onenoober/price_overview/_samples/batch2/pdf_text_summary.txt

--- RM-JJ-00083707-01.pdf
技术要求：
1.零件表面不得存在划痕、擦伤等损坏零
件表面的缺陷。 
2.去除毛刺飞边，锐角倒钝。 
3.对于无特殊要求的螺纹孔，需要贯通；
对于未贯通的螺纹孔，有效螺纹深度不小
于螺纹外径的2倍。 
4.加工后存放时必须合理支撑，避免零件
弯曲。 
5.未标注尺寸参见3D。 
6.未标注公差参照右侧标题栏参数。 
105
120
35
2 x 
 5.5 完全贯穿
 4.2 
 12.4
 M5 - 6H 
 10
细牙
2 x 
10.1
5
A
A
10.1
10.1
5 ±0.01
9
119.1
20
A-A
20
此面及棱角处
务必抛光处理
3.2
其余
修订表
标记
修订说明
处数
签名
日期
D
C
A
B
D
C
A
B
6
5
4
3
2
1
6
5
4
3
2
1
>400～1200
±0.2
±0.3
未注公差标记
>30～120 ±0.15
±0.1
±0.05
>120～400
>6～30
>0.5～6
45
投 影
表面
处理
热处理
重量(Kg)
物件料号
0.52
压板
材料
1:1
比 例
征图新视(江苏)科技股份有限公司
Focusight Technology Co.,Ltd
设计
审核
批准
零件类型
镀亮铬
RM-JJ-00083707
方件类
版 本
01
郭江峰
2026-04-24
郭江峰
2026-04-24

--- RM-JJ-00083725-01.pdf
技术要求：
1.零件表面不得存在划痕、擦伤等损坏零
件表面的缺陷。 
2.去除毛刺飞边，锐角倒钝。 
3.对于无特殊要求的螺纹孔，需要贯通；
对于未贯通的螺纹孔，有效螺纹深度不小
于螺纹外径的2倍。 
4.加工后存放时必须合理支撑，避免零件
弯曲。 
5.未标注尺寸参见3D。 
6.未标注公差参照右侧标题栏参数。 
4 x 
 6.8 完全贯穿
M8 - 6H 完全贯穿
8 x 
 3.3 完全贯穿
M4 - 6H 完全贯穿
4 x 
 19.1 完全贯穿
 10.2 完全贯穿
M12 - 6H 完全贯穿
4 x 
 4.2 完全贯穿
M5 - 6H 完全贯穿
0
15
45
37.5
62.5
70
100
130
137.5
162.5
155
185
200
0
5.5
15
20
34.5
42.5
87.5
57.5
72.5
65
95.5
110
124.5
115
130
12 ±0.02
3.2
其余
修订表
标记
修订说明
处数
签名
日期
D
C
A
B
D
C
A
B
6
5
4
3
2
1
6
5
4
3
2
1
>400～1200
±0.2
±0.3
未注公差标记
>30～120 ±0.15
±0.1
±0.05
>120～400
>6～30
>0.5～6
6061
投 影
表面
处理
热处理
重量(Kg)
物件料号
0.72
传动护罩
材料
1:1
比 例
征图新视(江苏)科技股份有限公司
Focusight Technology Co.,Ltd
设计
审核
批准
零件类型
本色氧化，喷砂
RM-JJ-00083725
方件类
版 本
01
郭江峰
2026-04-24
郭江峰
2026-04-24

--- RM-JJ-00083828-01.pdf
技术要求：
1.零件表面不得存在划痕、擦伤等损坏零
件表面的缺陷。 
2.去除毛刺飞边，锐角倒钝。 
3.对于无特殊要求的螺纹孔，需要贯通；
对于未贯通的螺纹孔，有效螺纹深度不小
于螺纹外径的2倍。 
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
㣊㘜
㦶㠻
D
C
A
B
D
C
A
B
6
5
4
3
2
1
6
5
4
3
2
1
>400～1200
±0.2
±0.3
未注公差标记
>30～120 ±0.15
±0.1
±0.05
>120～400
>6～30
>0.5～6
Q235A
投 影
表面
处理
热处理
重量(Kg)
物件料号
5.18
输送支撑架
材料
1:6
比 例
征图新视(江苏)科技股份有限公司
Focusight Technology Co.,Ltd
设计
审核
批准
零件类型
喷塑小桔纹白色
RM-JJ-00084398
方件类
版 本
01
赵洲
2026-04-24
赵洲
2026-04-24
