onenoober/price_overview/_samples/five/pdf_text_summary.txt

--- RM-JJ-00083854-01.pdf
技术要求：
1.零件表面不得存在划痕、擦伤等损坏零
件表面的缺陷。 
2.去除毛刺飞边，锐角倒钝。 
3.对于无特殊要求的螺纹孔，需要贯通；
对于未贯通的螺纹孔，有效螺纹深度不小
于螺纹外径的2倍。 
4.加工后存放时必须合理支撑，避免零件
弯曲。 
5.未标注尺寸参见3D。 
6.未标注公差参照右侧标题栏参数。 
62 ±0.05
80.5
12
12
22.5
30
70
2 x 
 5 完全贯穿
M6 - 6H 完全贯穿
10.2
10
50
2 x 
 3.3 
 10.1
M4 - 6H 
 8
3 x 
 5 
 15
M6 - 6H 
 12
4 H7 X 5 
 15
 4 H7 
 15
20
0
10
22.5 ±0.02
35
60
47.5
3.2
其余
修订表
标记
修订说明
处数
签名
日期
D
C
A
B
D
C
A
B
6
5
4
3
2
1
6
5
4
3
2
1
>400～1200
±0.2
±0.3
未注公差标记
>30～120 ±0.15
±0.1
±0.05
>120～400
>6～30
>0.5～6
45
投 影
表面
处理
热处理
重量(Kg)
物件料号
0.796
后侧板
材料
1:1
比 例
征图新视(江苏)科技股份有限公司
Focusight Technology Co.,Ltd
设计
审核
批准
零件类型
镀硬铬
RM-JJ-00083854
方件类
版 本
01
郭江峰
2026-04-24
郭江峰
2026-04-24

--- RM-JJ-00083859-01.pdf
技术要求：
1.零件表面不得存在划痕、擦伤等损坏零
件表面的缺陷。 
2.去除毛刺飞边，锐角倒钝。 
3.对于无特殊要求的螺纹孔，需要贯通；
对于未贯通的螺纹孔，有效螺纹深度不小
于螺纹外径的2倍。 
4.加工后存放时必须合理支撑，避免零件
弯曲。 
5.未标注尺寸参见3D。 
6.未标注公差参照右侧标题栏参数。 
25
80
115
110
150
EQS 4 x 
 5 完全贯穿
 M6 - 6H 完全贯穿
P.C.D 
56
2 x 
 12.2 完全贯穿
2 x 
 12.2 完全贯穿
6 x 
 9 完全贯穿
0
20
60
70
120
173 ±0.02
200
40
56
A
A
70
 4.2 贯穿
M5 - 6H 贯穿
12 ±0.02
 4.2 贯穿
M5 - 6H 贯穿
70
45 H7
12
A-A
3.2
其余
修订表
标记
修订说明
处数
签名
日期
D
C
A
B
D
C
A
B
6
5
4
3
2
1
6
5
4
3
2
1
>400～1200
±0.2
±0.3
未注公差标记
>30～120 ±0.15
±0.1
±0.05
>120～400
>6～30
>0.5～6
45
投 影
表面
处理
热处理
重量(Kg)
物件料号
1.984
张紧墙板
材料
1:1
比 例
征图新视(江苏)科技股份有限公司
Focusight Technology Co.,Ltd
设计
审核
批准
零件类型
镀硬铬
RM-JJ-00083859
方件类
版 本
01
郭江峰
2026-04-24
郭江峰
2026-04-24

--- RM-JJ-00083878-01.pdf
技术要求：
1.零件表面不得存在划痕、擦伤等损坏零
件表面的缺陷。 
2.去除毛刺飞边，锐角倒钝。 
3.对于无特殊要求的螺纹孔，需要贯通；
对于未贯通的螺纹孔，有效螺纹深度不小
于螺纹外径的2倍。 
4.加工后存放时必须合理支撑，避免零件
弯曲。 
5.未标注尺寸参见3D。 
6.未标注公差参照右侧标题栏参数。 
40
50
8
70
25
9 X 21 完全贯穿
80
20
30
2 x 
 7 完全贯穿
12
12
零件可拼焊接
3.2
其余
修订表
标记
修订说明
处数
签名
日期
D
C
A
B
D
C
A
B
6
5
4
3
2
1
6
5
4
3
2
1
>400～1200
±0.2
±0.3
未注公差标记
>30～120 ±0.15
±0.1
±0.05
>120～400
>6～30
>0.5～6
45
投 影
表面
处理
热处理
重量(Kg)
物件料号
0.610
L脚
材料
1:1
比 例
征图新视(江苏)科技股份有限公司
Focusight Technology Co.,Ltd
设计
审核
批准
零件类型
镀硬铬
RM-JJ-00083878
方件类
版 本
01
郭江峰
2026-04-24
郭江峰
2026-04-24

--- RM-JJ-00083991-01.pdf
技术要求：
1.零件表面不得存在划痕、擦伤等损坏
零件表面的缺陷。 
2.去除毛刺飞边，锐角倒钝。 
3.未标注尺寸参见3D。 
4.未标注公差参照右侧标题栏参数。 
10
27.5
45
80
11
6.6
C1
A
A
8 
+
 
0.02
0
5.5
10
5.7
2
6.8
15
A-A
镀化学镍
3.2
其余
修订表
标记
处数
修订说明
签名
日期
>400～1200
±0.2
±0.3
未注公差标记
>30～120 ±0.15
±0.1
±0.05
>120～400
>6～30
>0.5～6
45
投 影
表面
处理
热处理
重量(Kg)
D
C
A
B
3
5
2
6
4
1
物件料号RM-JJ-00083991
轴承安装板
镀化学镍
材料
1:1
比 例
征图新视(江苏)科技股份有限公司
Focusight Technology Co.,Ltd
D
设计
审核
5
6
4
3
C
批准
A
B
2
1
零件类型
0.08
方件类
版本
01
赵洲
2026-04-24
赵洲
2026-04-24

--- RM-JJ-00084339-01.pdf
技术要求：
1.零件表面不得存在划痕、擦伤等损坏零
件表面的缺陷。 
2.去除毛刺飞边，锐角倒钝。 
3.对于无特殊要求的螺纹孔，需要贯通；
对于未贯通的螺纹孔，有效螺纹深度不小
于螺纹外径的2倍。 
4.加工后存放时必须合理支撑，避免零件
弯曲。 
5.未标注尺寸参见3D。 
6.未标注公差参照右侧标题栏参数。 
11
95.8
15
2 x 
 5.5 完全贯穿
 10 
 5.7
7.5
20 
+
+
0.50
0.20
5
37.9
 M6 - 6H 
 12
 5 
 17两端
15
20
10
3.2
其余
修订表
标记
修订说明
处数
签名
日期
D
C
A
B
D
C
A
B
6
5
4
3
2
1
6
5
4
3
2
1
>400～1200
±0.2
±0.3
未注公差标记
>30～120 ±0.15
±0.1
±0.05
>120～400
>6～30
>0.5～6
6061
投 影
表面
处理
热处理
重量(Kg)
物件料号
0.068
对接流利条支撑板
材料
1:1
比 例
征图新视(江苏)科技股份有限公司
Focusight Technology Co.,Ltd
设计
审核
批准
零件类型
本色阳极氧化
RM-JJ-00084339
方件类
版 本
01
赵洲
2026-04-24
赵洲
2026-04-24
