onenoober/price_overview/_samples/batch2/rendered/RM-JJ-00083841-01.png

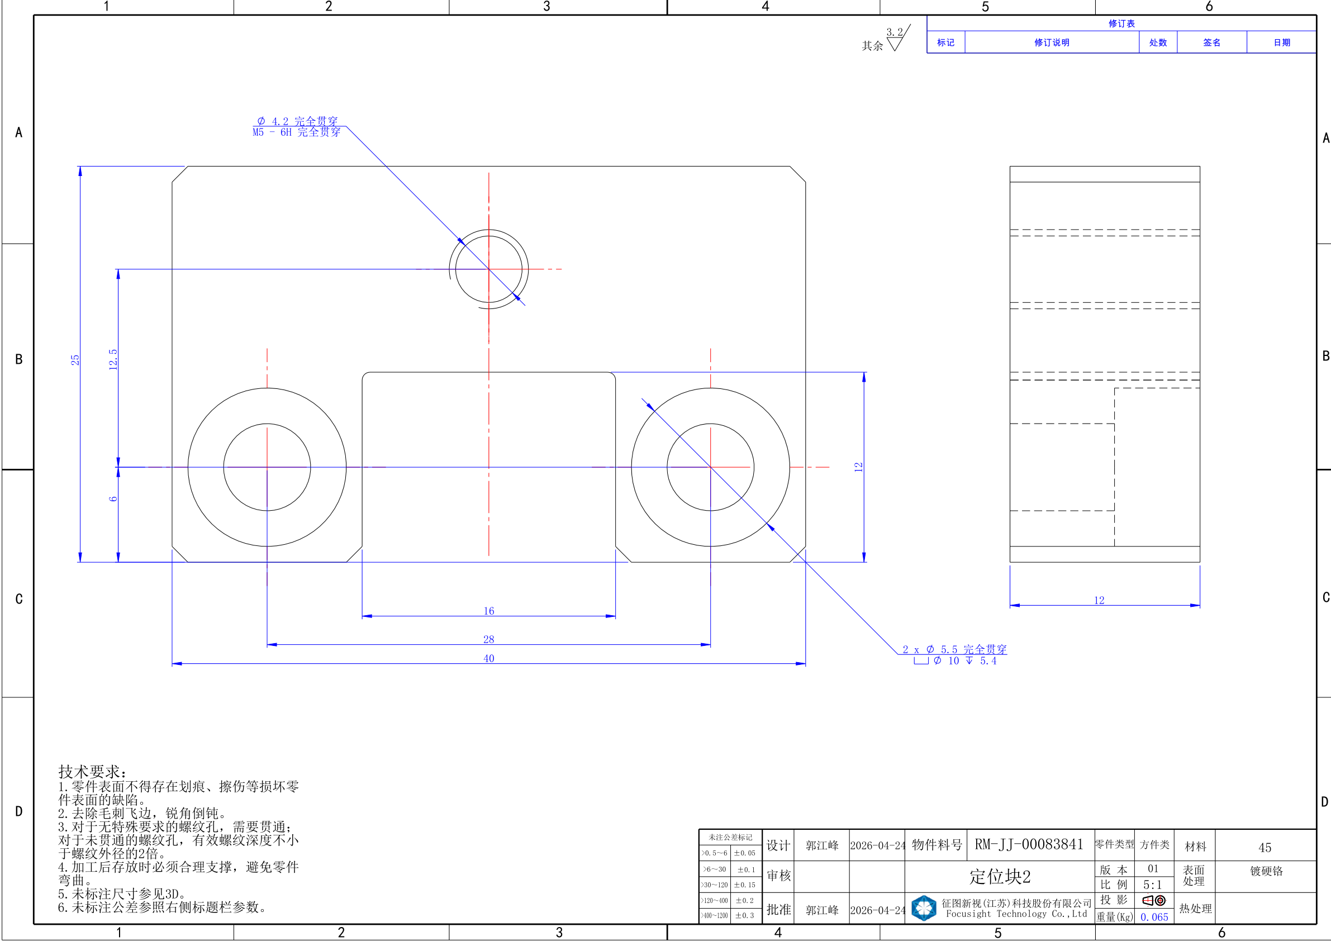
_samples/batch2/rendered/RM-JJ-00083841-01.png
