onenoober/price_overview/_samples/batch2/rendered/RM-JJ-00084186-01.png

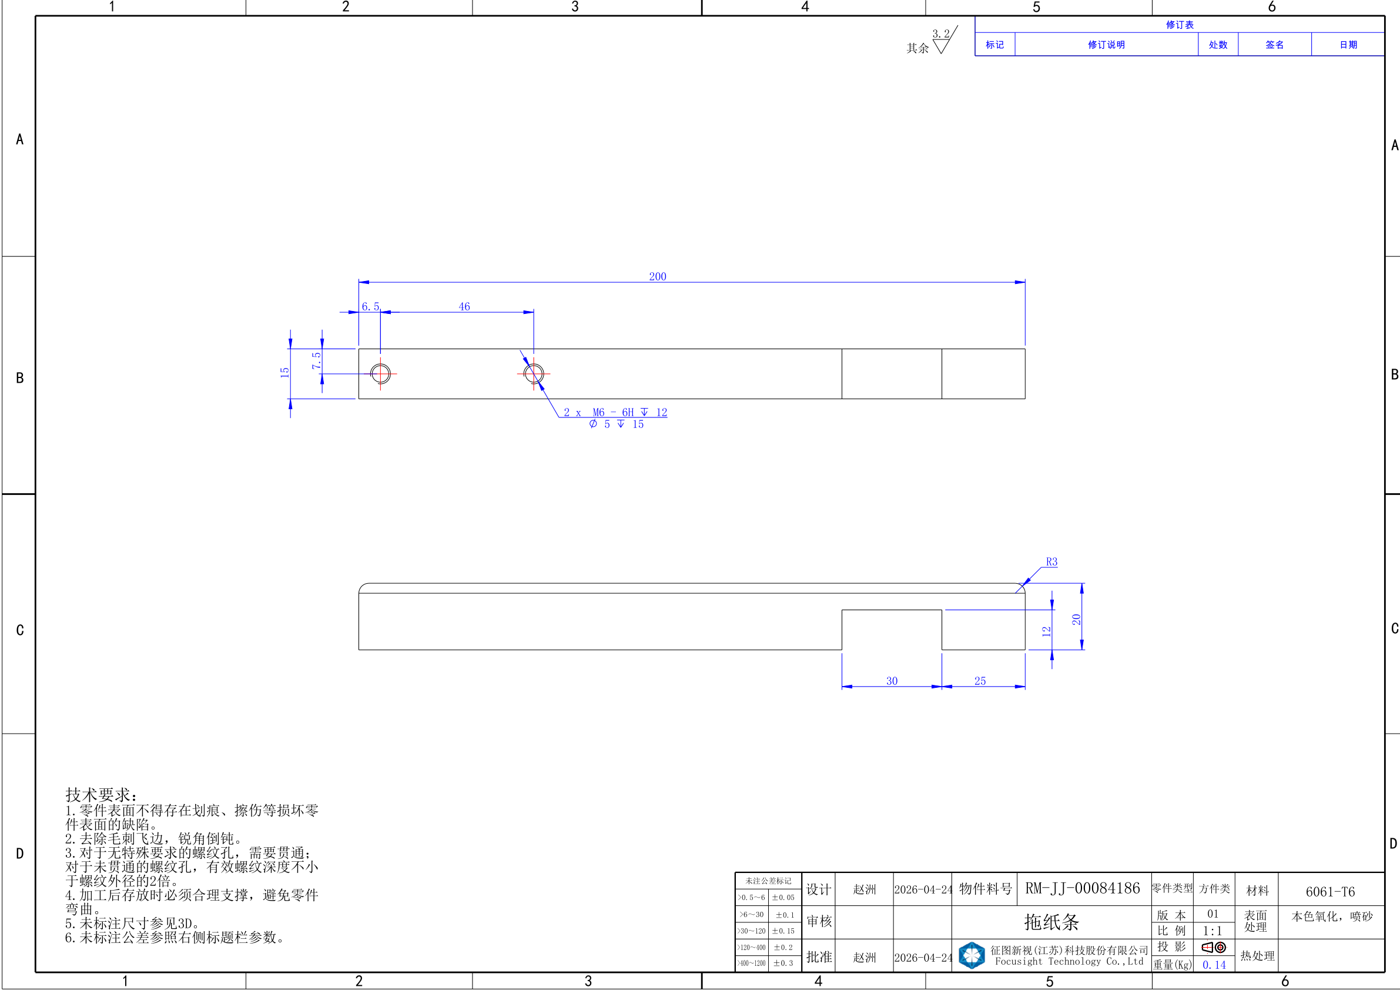
_samples/batch2/rendered/RM-JJ-00084186-01.png
