onenoober/price_overview/_samples/five/rendered/RM-JJ-00083878-01.png

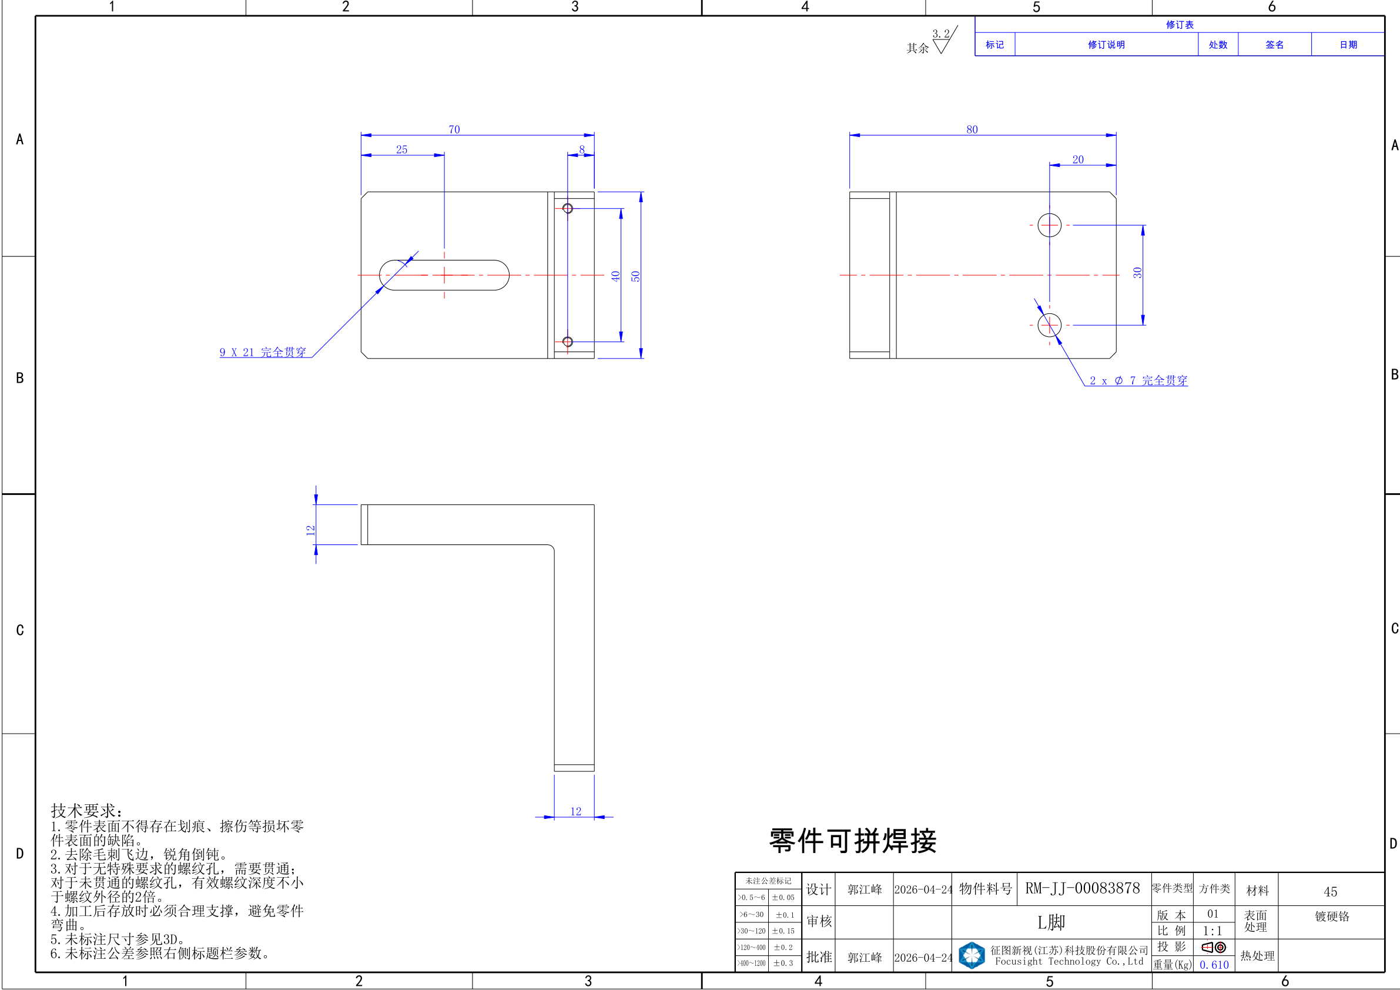
_samples/five/rendered/RM-JJ-00083878-01.png
