onenoober/price_overview/_samples/five/rendered/RM-JJ-00083991-01.png

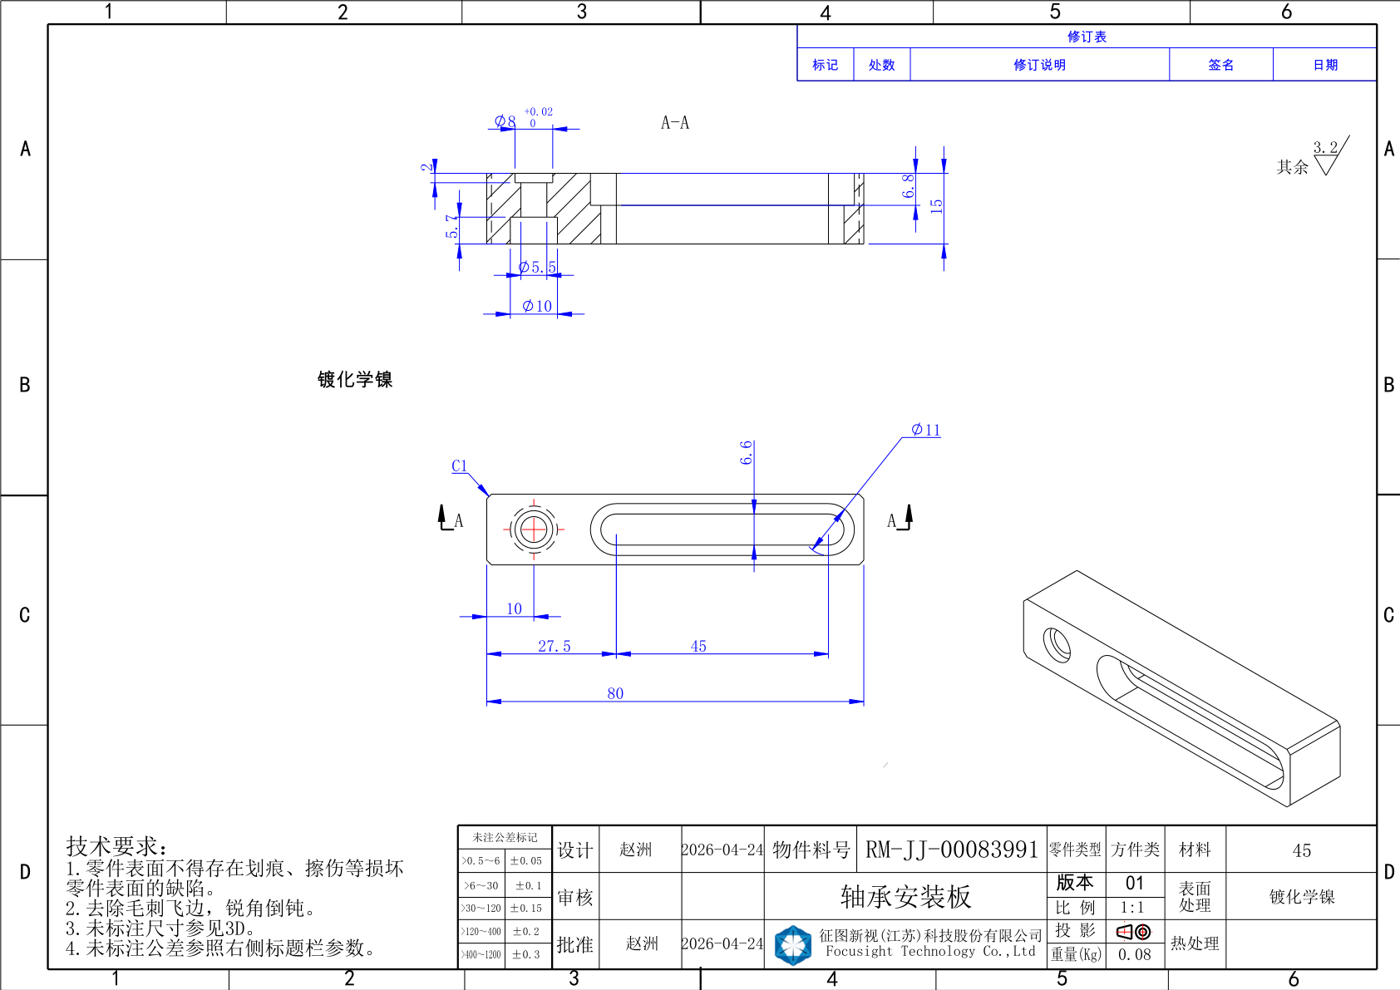
_samples/five/rendered/RM-JJ-00083991-01.png
