onenoober/price_overview/_samples/batch2/RM-JJ-00084186-01.step

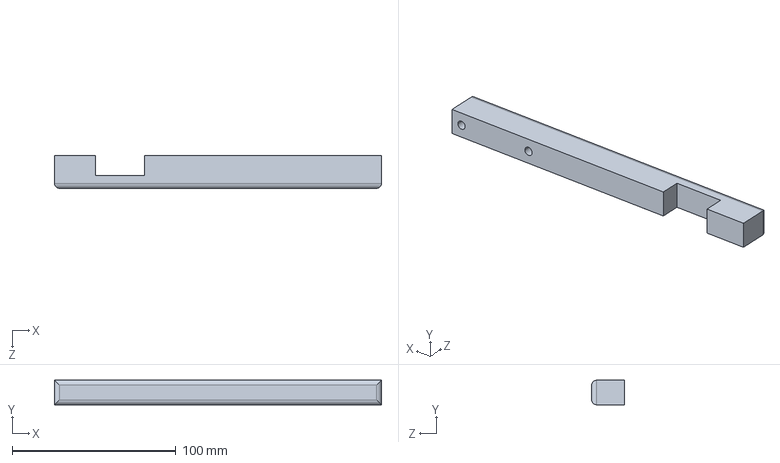
[picture p15: CAD file, 2026-07-01]
_samples/batch2/RM-JJ-00084186-01.step
200.0 x 15.0 x 20.0 mm
