onenoober/price_overview/_samples/five/RM-JJ-00083878-01.step

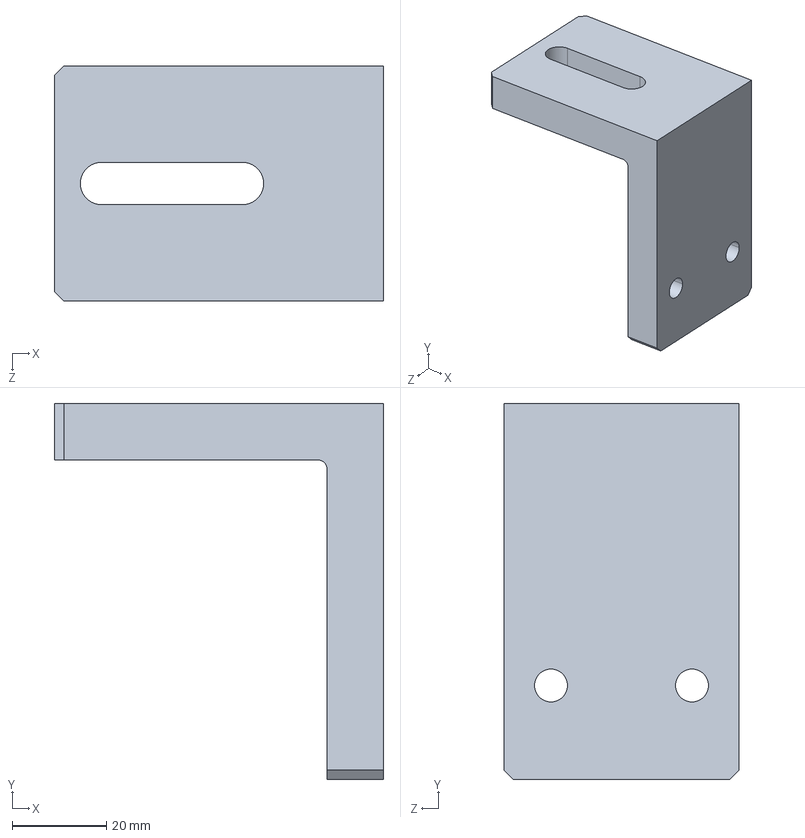
[picture p16: CAD file, 2026-07-01]
_samples/five/RM-JJ-00083878-01.step
70.0 x 80.0 x 50.0 mm
