onenoober/price_overview/_samples/batch2/RM-JJ-00084398-01.step

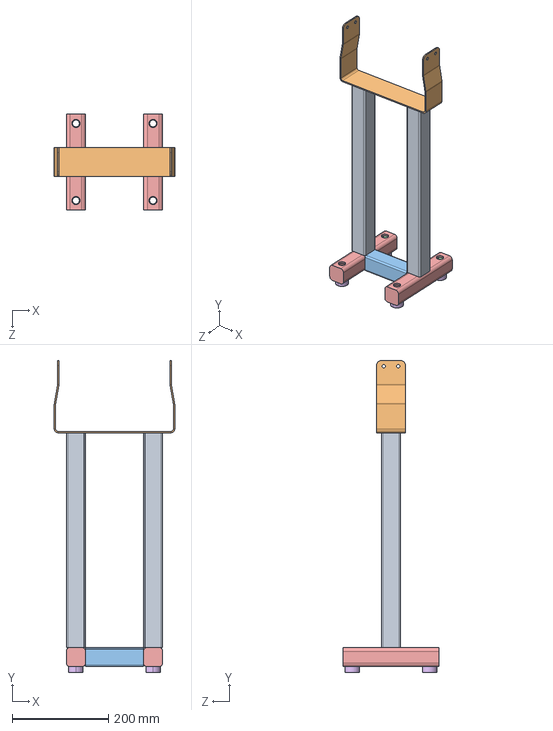
[picture p17: CAD file, 2026-07-01]
_samples/batch2/RM-JJ-00084398-01.step
250.0 x 647.0 x 200.0 mm
