onenoober/price_overview/_samples/five/RM-JJ-00083991-01.step

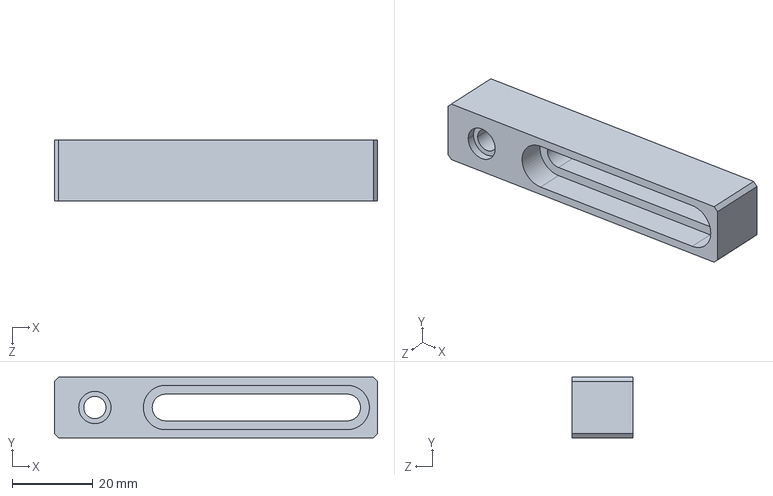
[picture p20: CAD file, 2026-07-01]
_samples/five/RM-JJ-00083991-01.step
80.0 x 15.0 x 15.0 mm
