onenoober/price_overview/_samples/batch2/RM-JJ-00083707-01.step

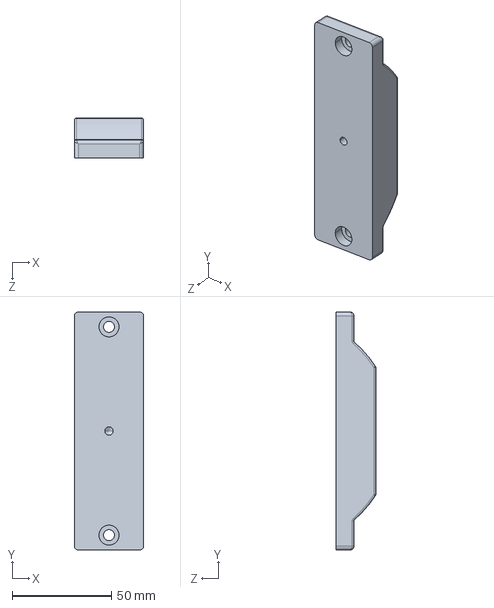
[picture p21: CAD file, 2026-07-01]
_samples/batch2/RM-JJ-00083707-01.step
35.0 x 120.0 x 20.0 mm
