onenoober/price_overview/_samples/batch2/RM-JJ-00083841-01.step

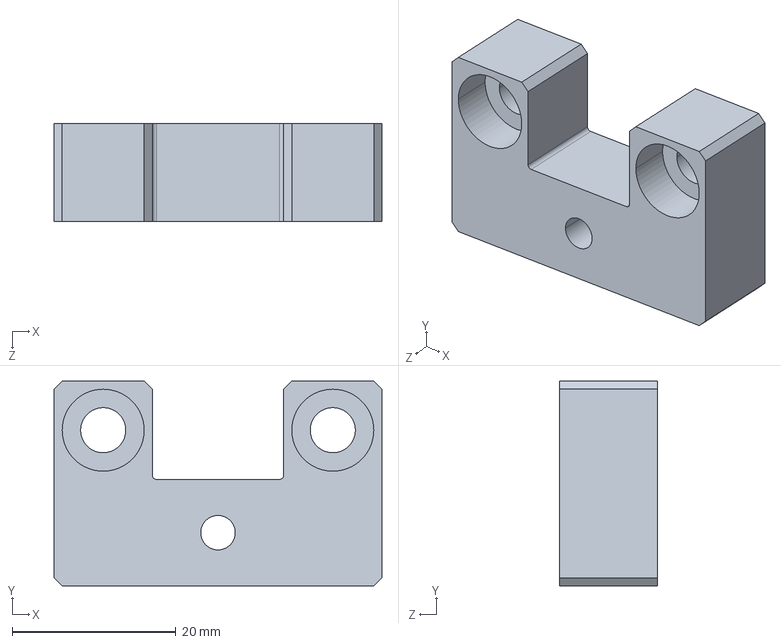
[picture p24: CAD file, 2026-07-01]
_samples/batch2/RM-JJ-00083841-01.step
40.0 x 25.0 x 12.0 mm
