onenoober/price_overview/_samples/batch2/RM-JJ-00083707-01.pdf

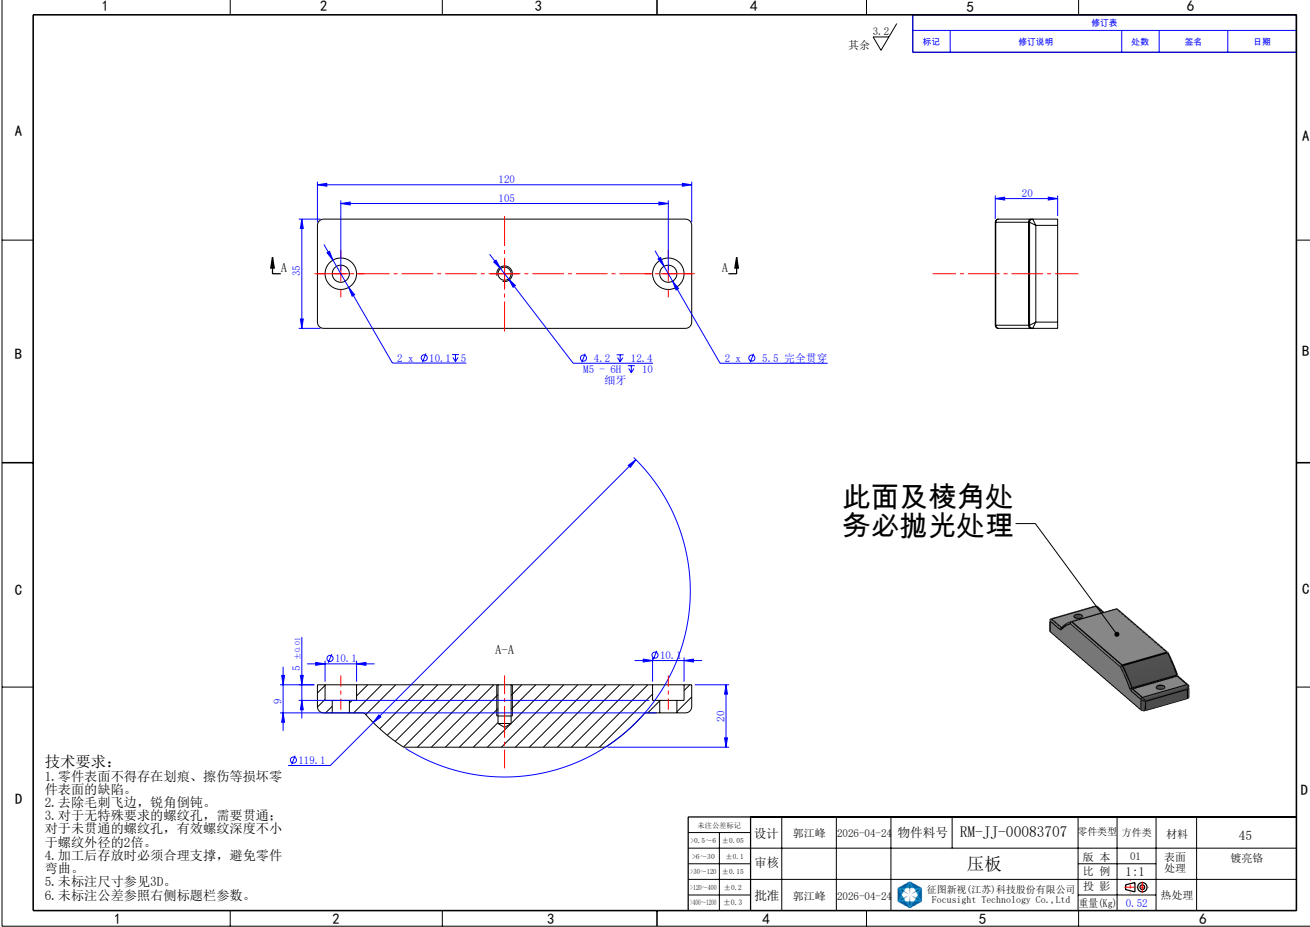
[picture p25: page 1]
5.5 完全贯穿

修订表

标记 | 修订说明 | 处数 | 签名 | 日期

征图新视(江苏)科技股份有限公司
Focusight Technology Co.,Ltd

0.52 | 热处理 重量(Kg)
