onenoober/price_overview/_samples/batch2/RM-JJ-00083841-01.pdf

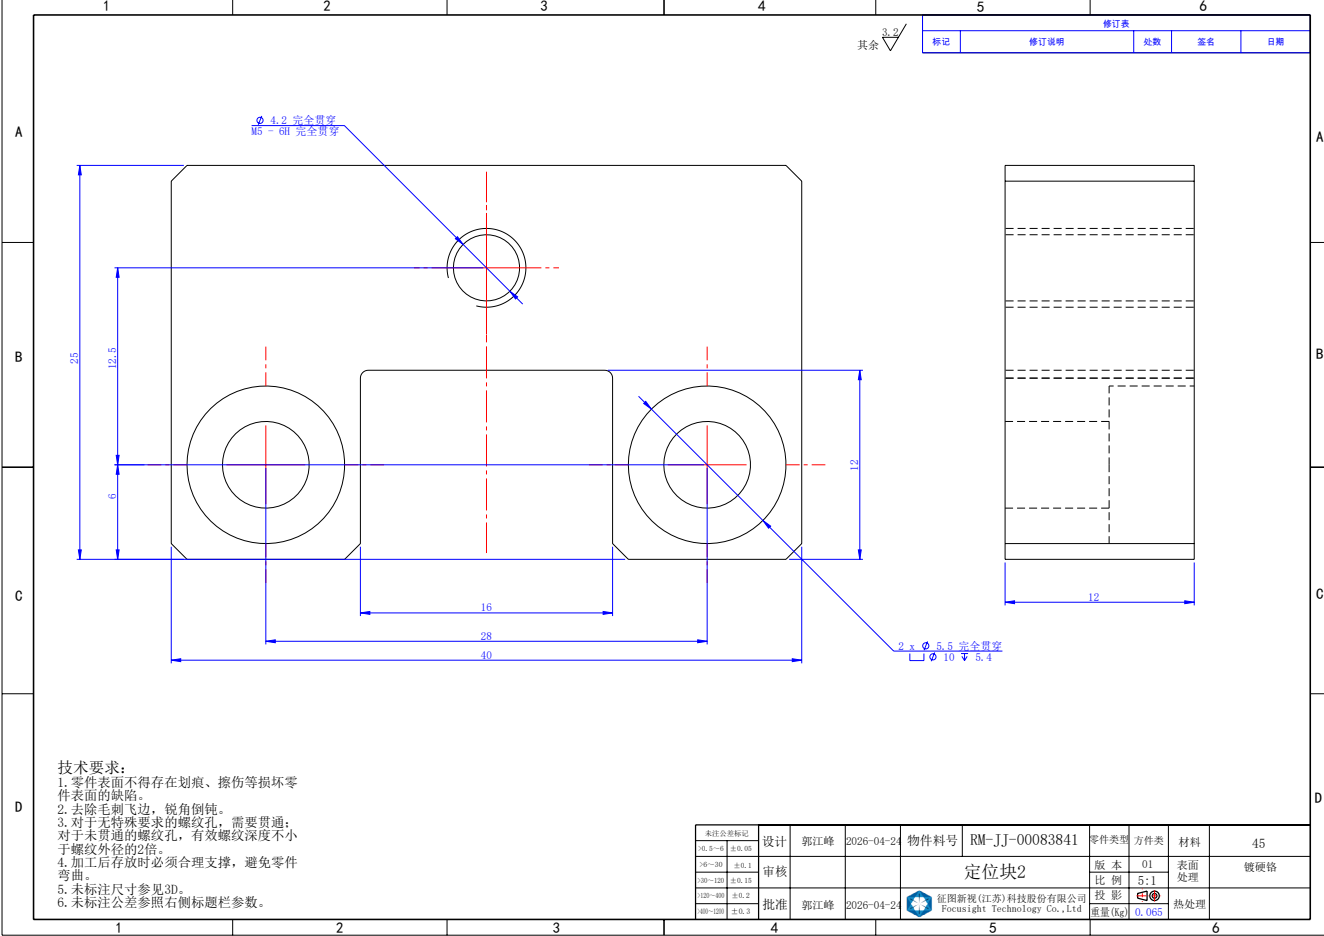
[picture p28: page 1]
4.2 完全贯穿 M5 - 6H 完全贯穿; 5.5 完全贯穿

修订表

标记 | 修订说明 | 处数 | 签名 | 日期

征图新视(江苏)科技股份有限公司
Focusight Technology Co.,Ltd

0.065 | 热处理 重量(Kg)
