onenoober/price_overview/_samples/batch2/RM-JJ-00084186-01.pdf

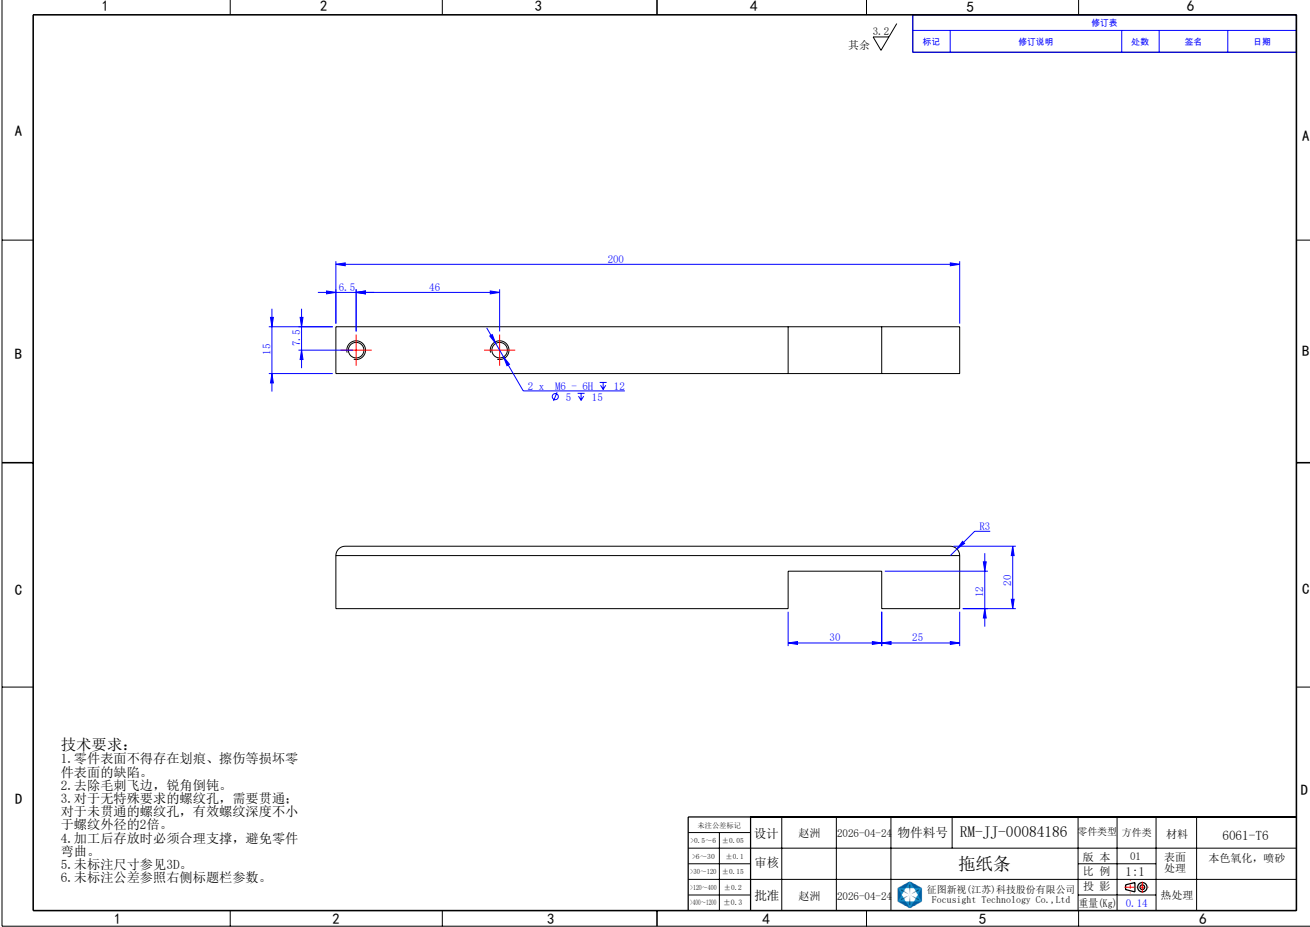
[picture p30: page 1]

修订表

标记 | 修订说明 | 处数 | 签名 | 日期

征图新视(江苏)科技股份有限公司
Focusight Technology Co.,Ltd

0.14 | 热处理 重量(Kg)
