onenoober/price_overview/_samples/batch2/RM-JJ-00084398-01.pdf

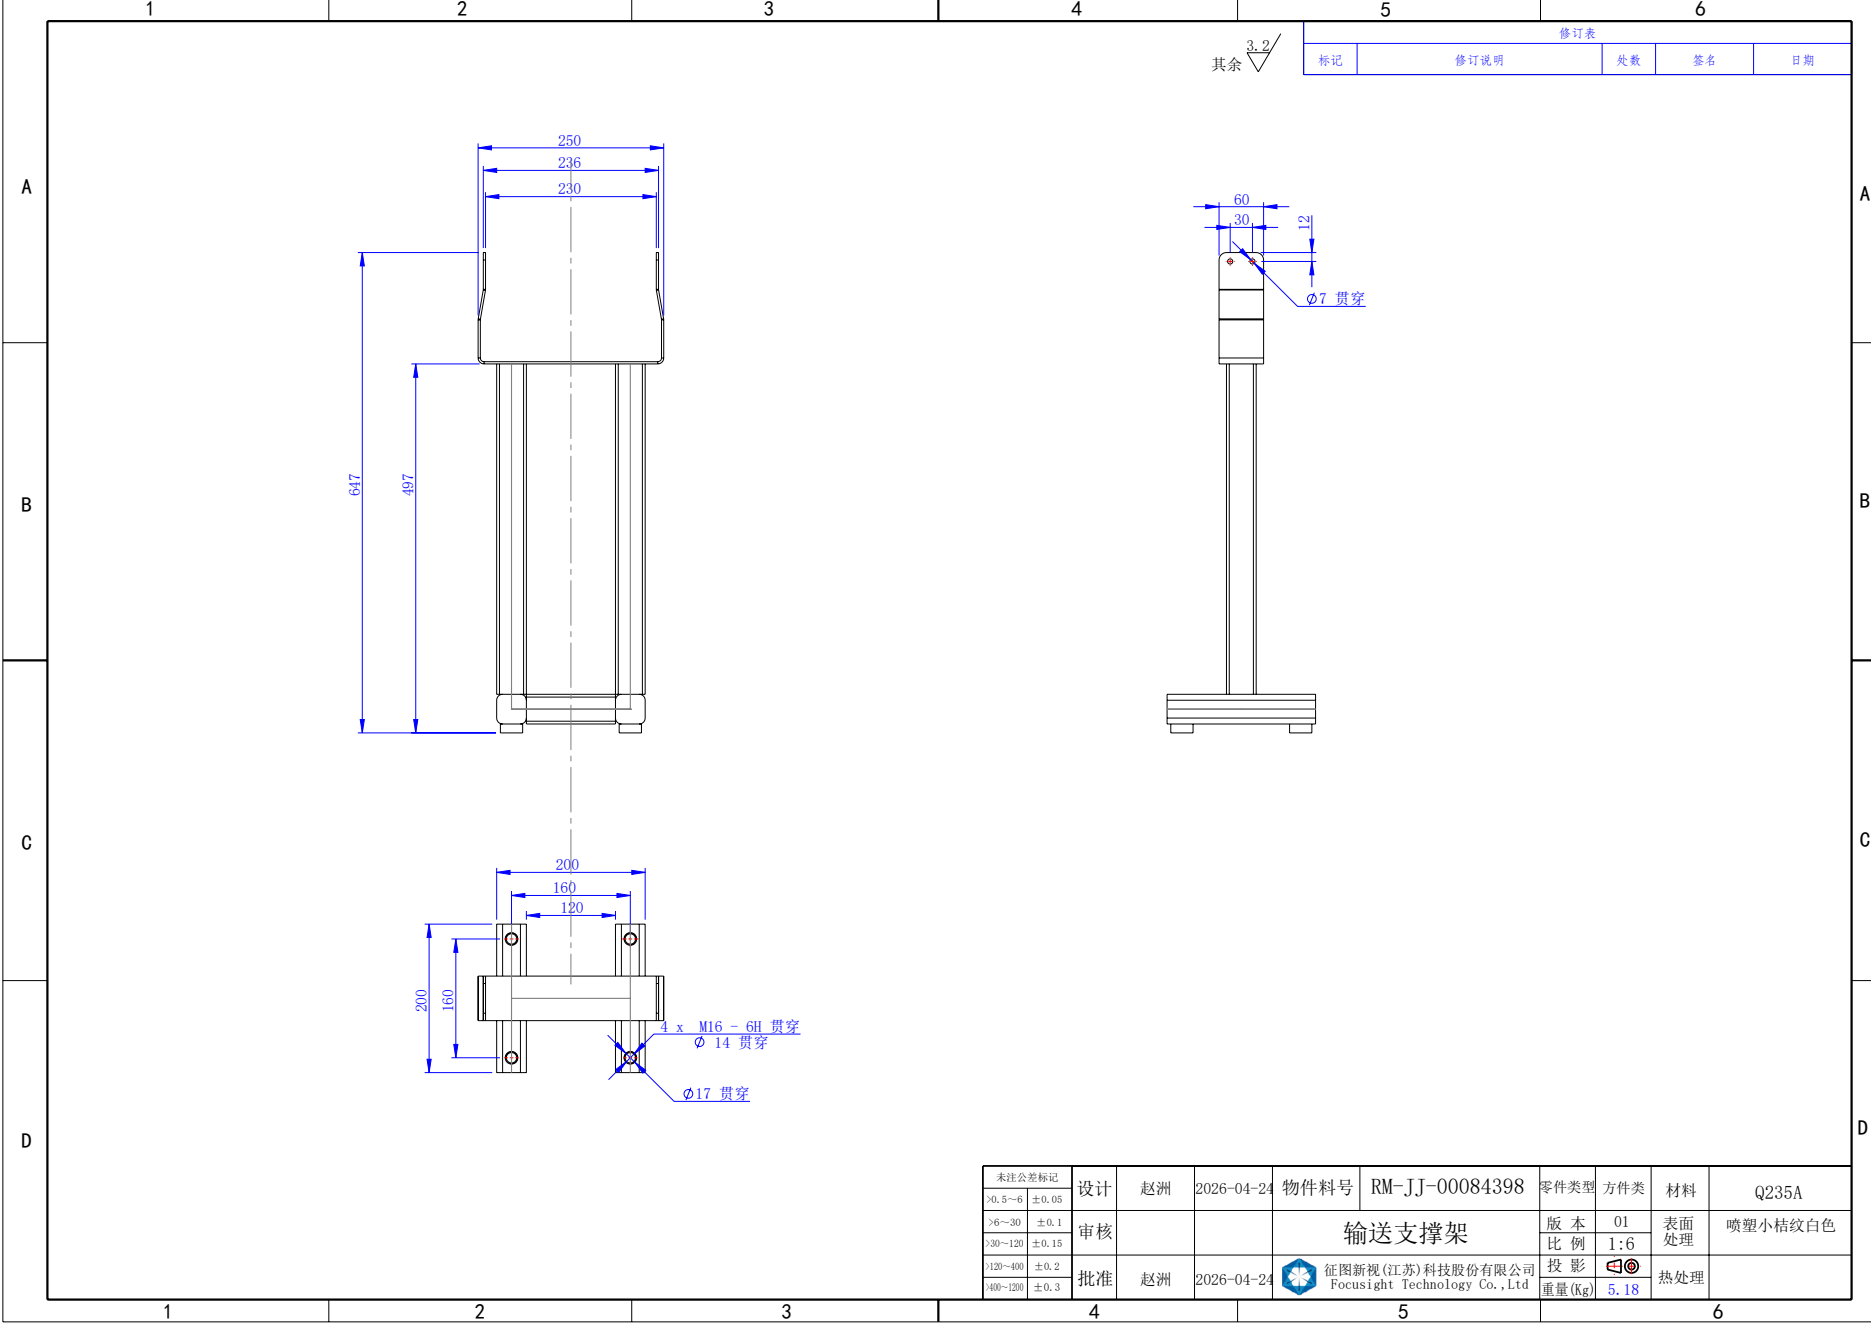
[picture p31: page 1]

征图新视(江苏)科技股份有限公司
Focusight Technology Co.,Ltd

5.18 | 热处理 重量(Kg)
