onenoober/price_overview/_samples/five/RM-JJ-00083878-01.pdf

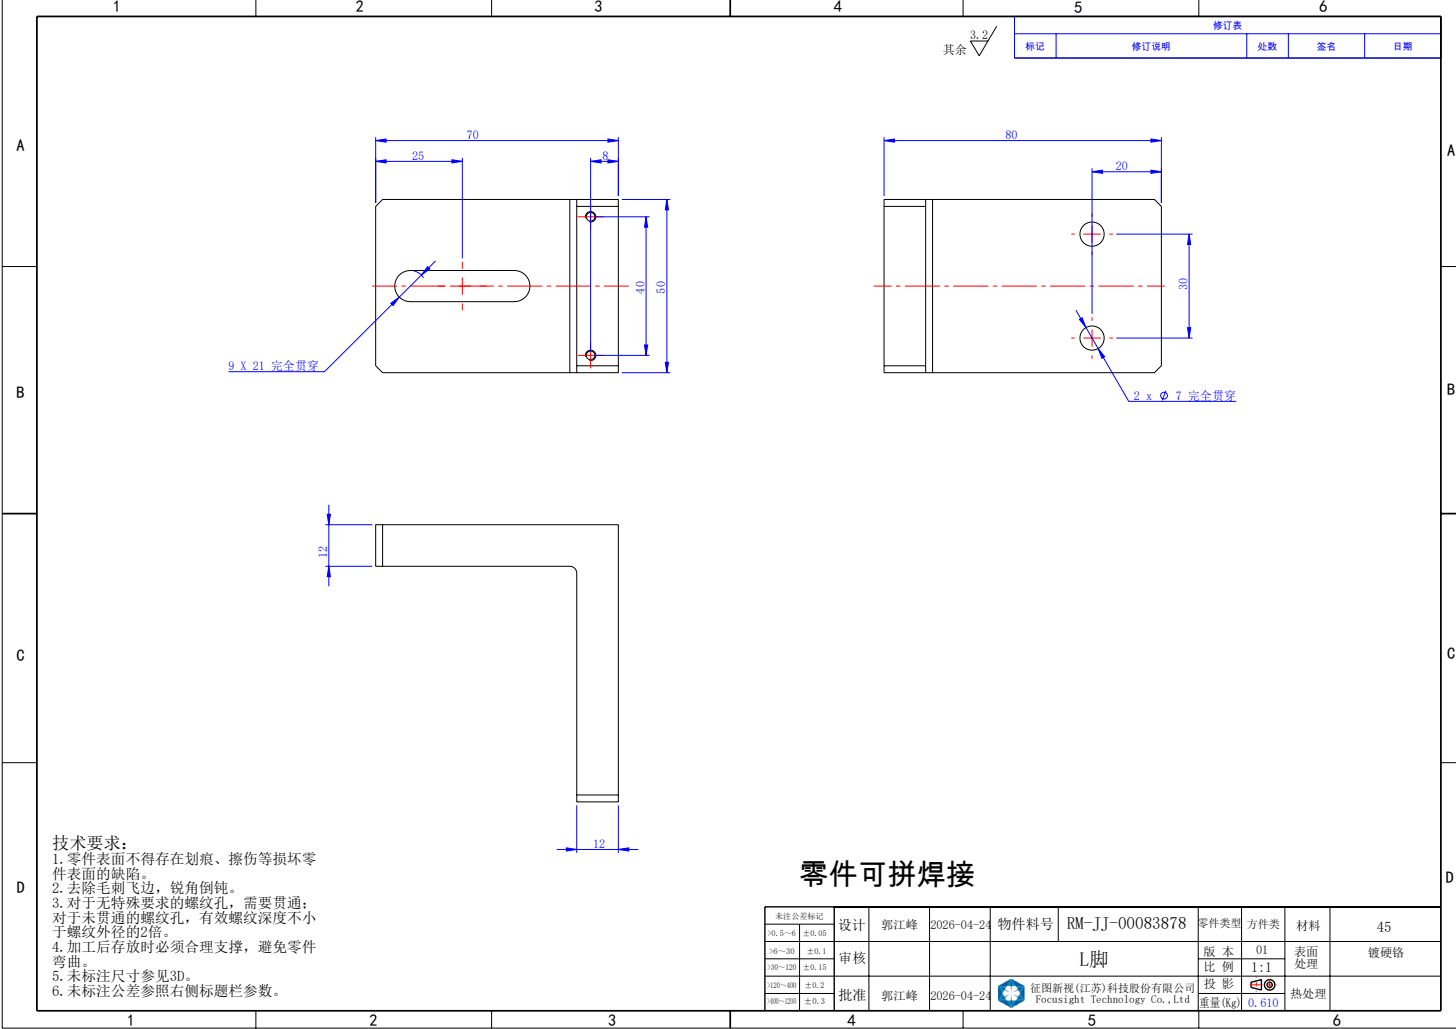
[picture p34: page 1]
9 X 21 完全贯穿; 7 完全贯穿

70 | 修订表

标记 | 修订说明 | 处数 | 签名 | 日期

征图新视(江苏)科技股份有限公司
Focusight Technology Co.,Ltd

0.610 | 热处理 重量(Kg)
