onenoober/price_overview/_samples/five/RM-JJ-00083991-01.pdf

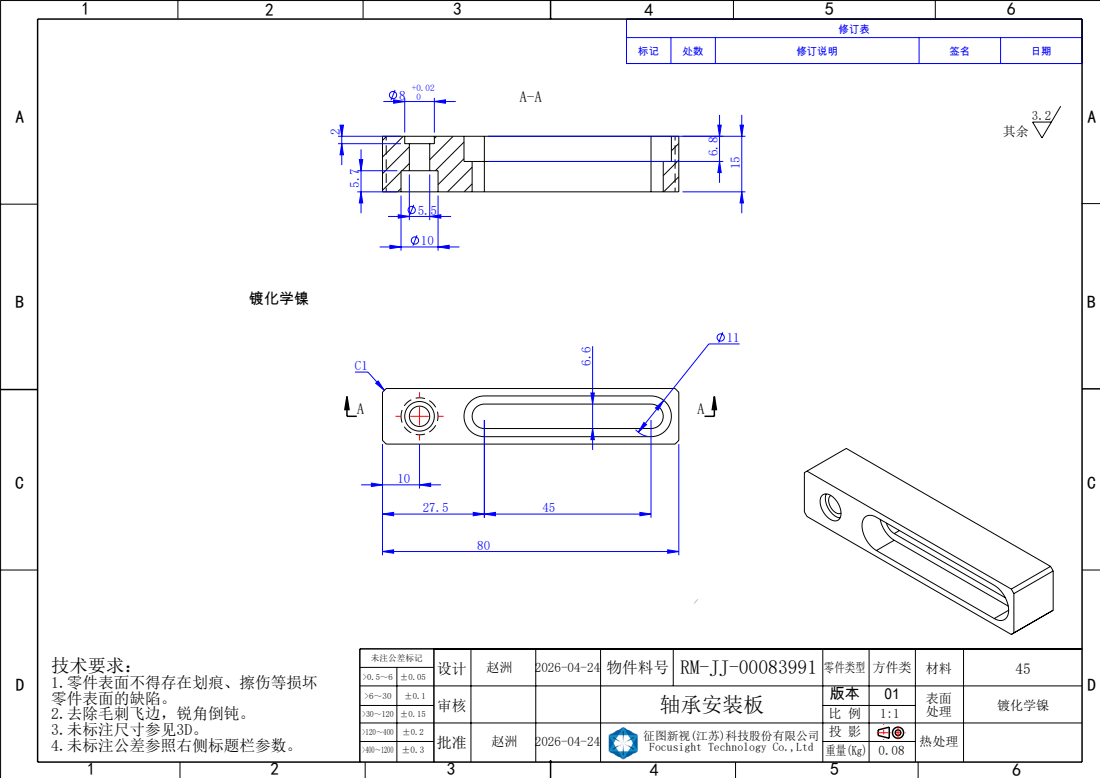
[picture p35: page 1]
投 影 热处理 重量(Kg)

物件料号 RM-JJ-00083991

征图新视(江苏)科技股份有限公司
Focusight Technology Co.,Ltd
