onenoober/price_overview/(commit log)

2026-06-10 规则触发工序
2026-06-12 Add market material pricing support
2026-06-15 Use AI material normalization for density
2026-06-15 Simplify material display in UI
2026-06-17 基础版本
2026-06-22 规则匹配工艺路线
2026-07-01 工序完整版
    [RM-JJ-00083707-01.step, RM-JJ-00083725-01.step, RM-JJ-00083828-01.step, RM-JJ-00083841-01.step, RM-JJ-00083854-01.step, RM-JJ-00083859-01.step, RM-JJ-00083878-01.step, RM-JJ-00083978-01.step]
